HarsiratSinghJouhal/low_cost_analog_ecg_monitor/media/image01.jpg

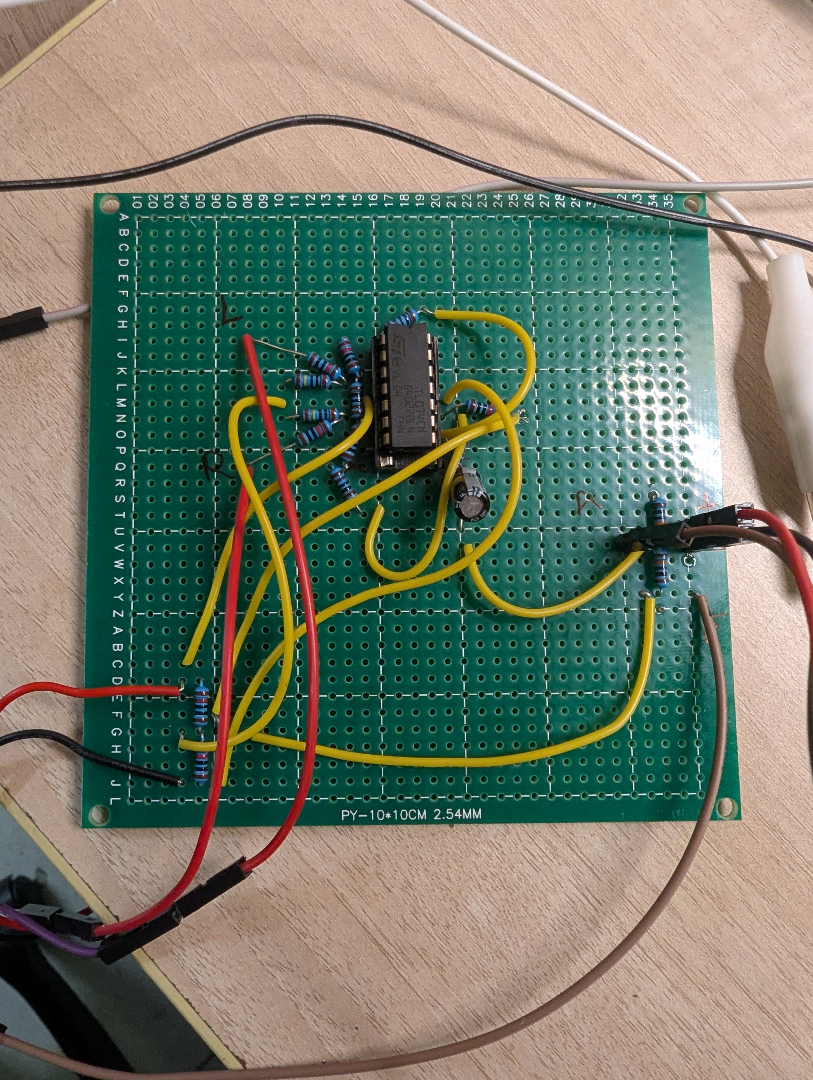
media/image01.jpg
