HarsiratSinghJouhal/low_cost_analog_ecg_monitor/media/image02.jpg

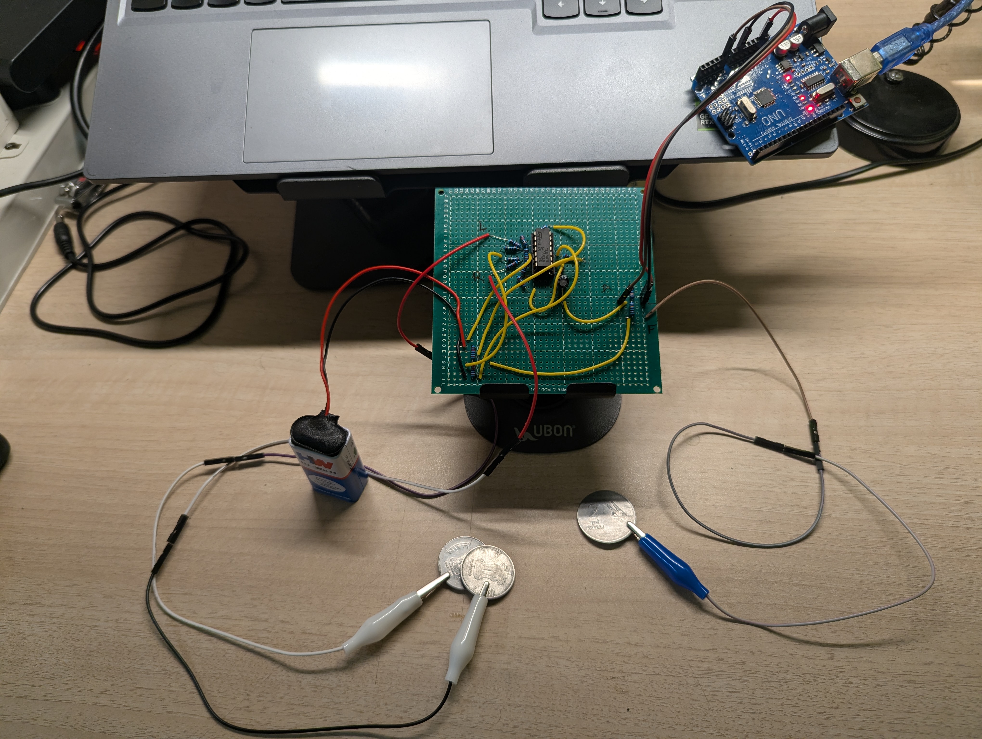
media/image02.jpg
