HarsiratSinghJouhal/low_cost_analog_ecg_monitor/media/image03.jpg

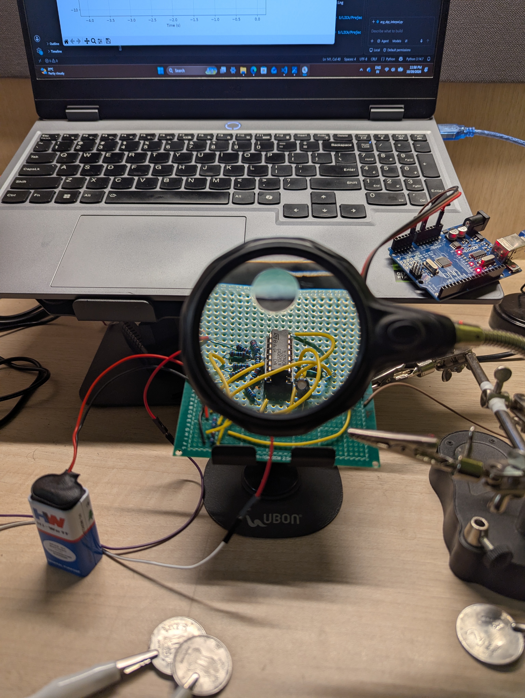
media/image03.jpg
