HarsiratSinghJouhal/low_cost_analog_ecg_monitor/media/image04.jpg

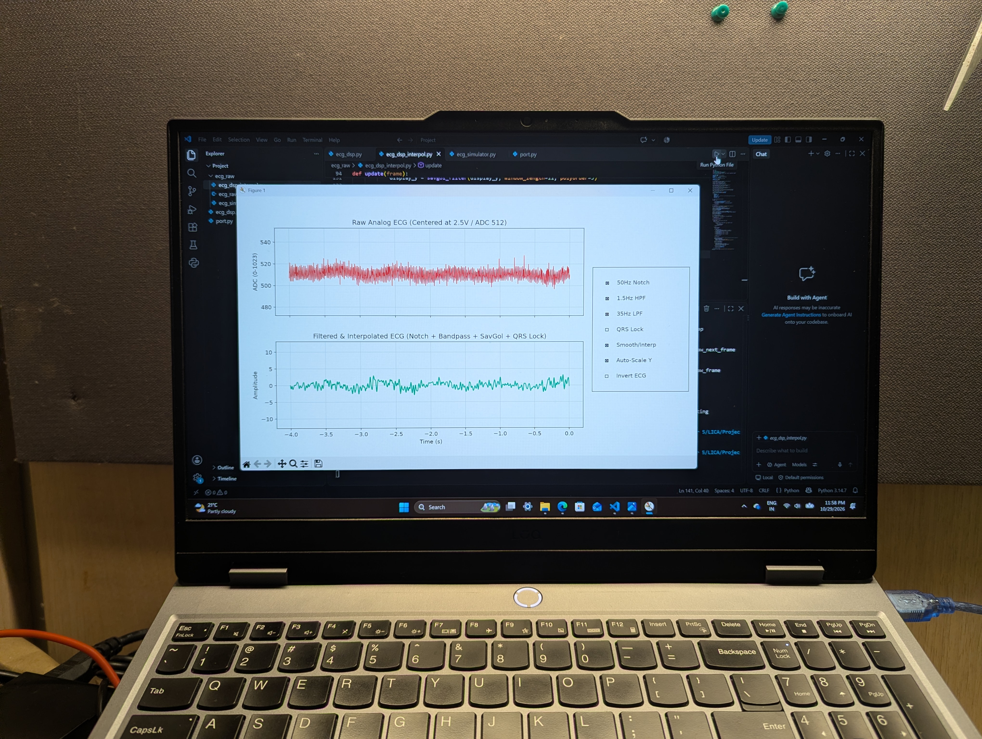
media/image04.jpg
