HarsiratSinghJouhal/low_cost_analog_ecg_monitor/media/image05.jpg

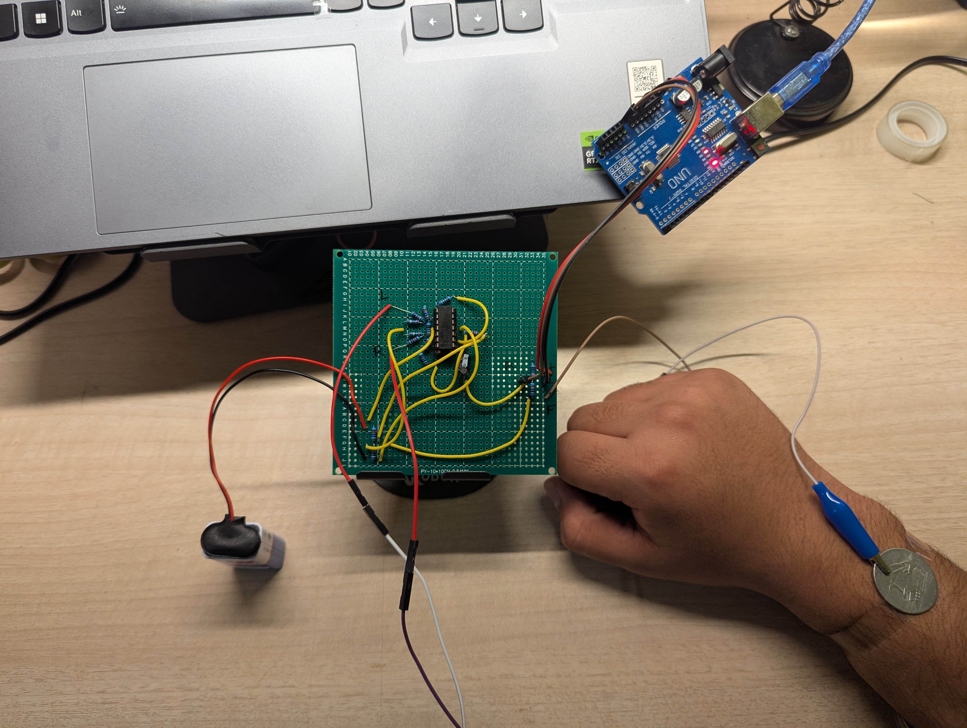
media/image05.jpg
