HarsiratSinghJouhal/low_cost_analog_ecg_monitor/media/image06.jpg

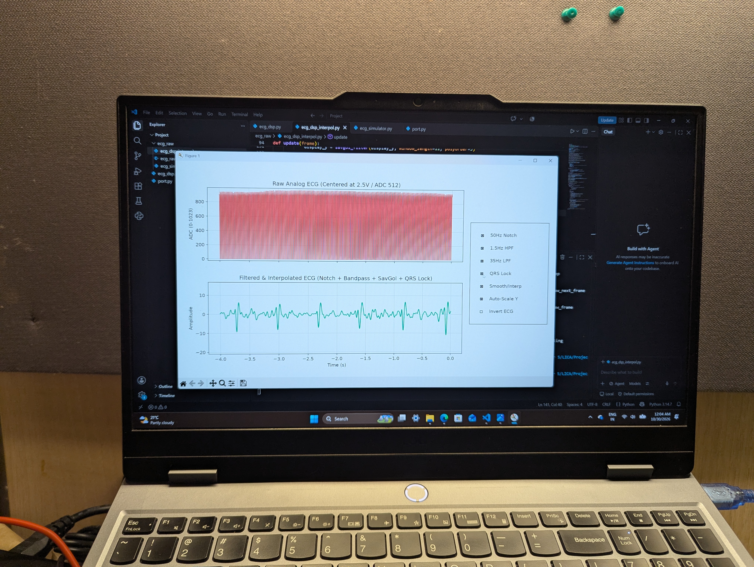
media/image06.jpg
