HarsiratSinghJouhal/low_cost_analog_ecg_monitor/media/image08.jpg

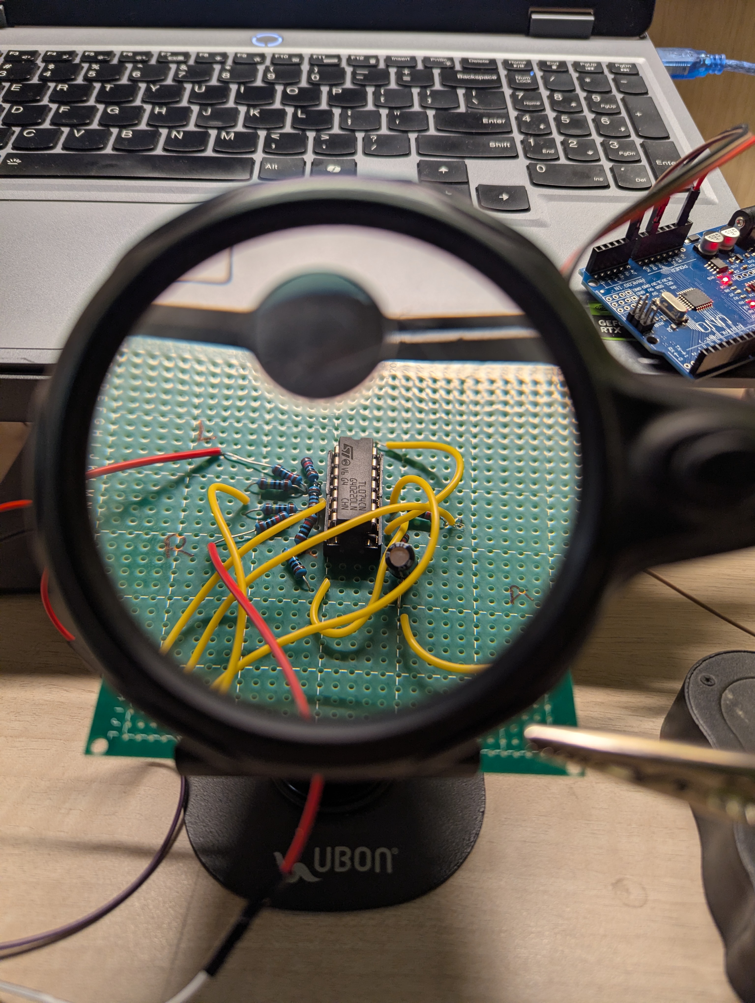
media/image08.jpg
