HarsiratSinghJouhal/low_cost_analog_ecg_monitor/media/waveform02.png

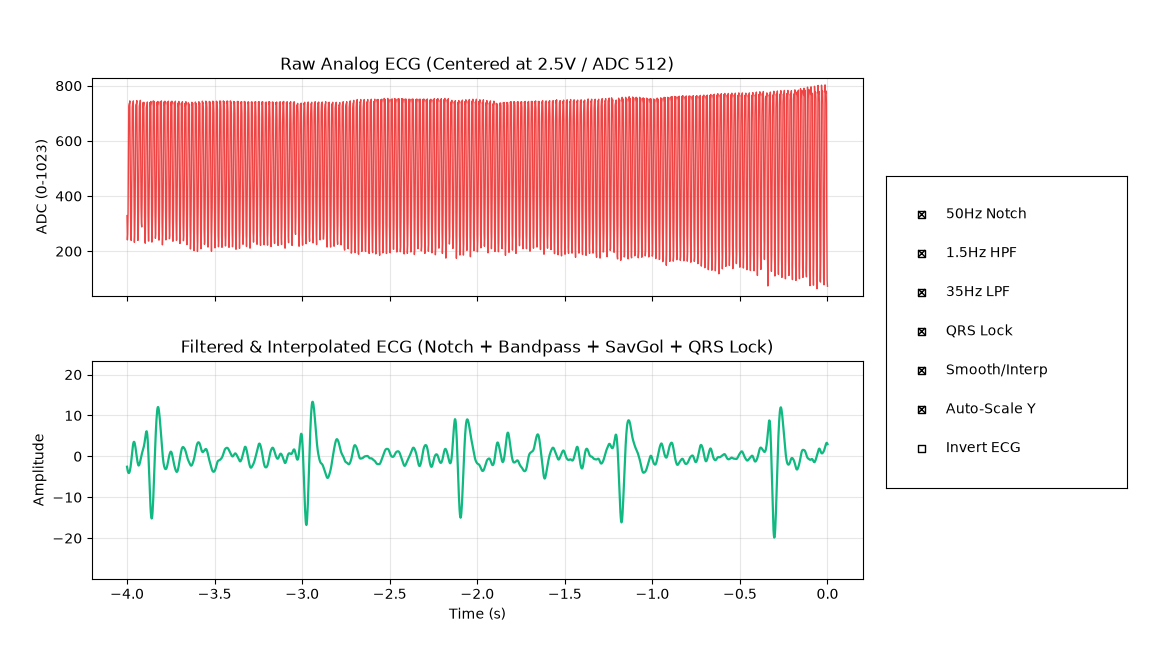
media/waveform02.png
