HarsiratSinghJouhal/low_cost_analog_ecg_monitor/media/waveform03.png

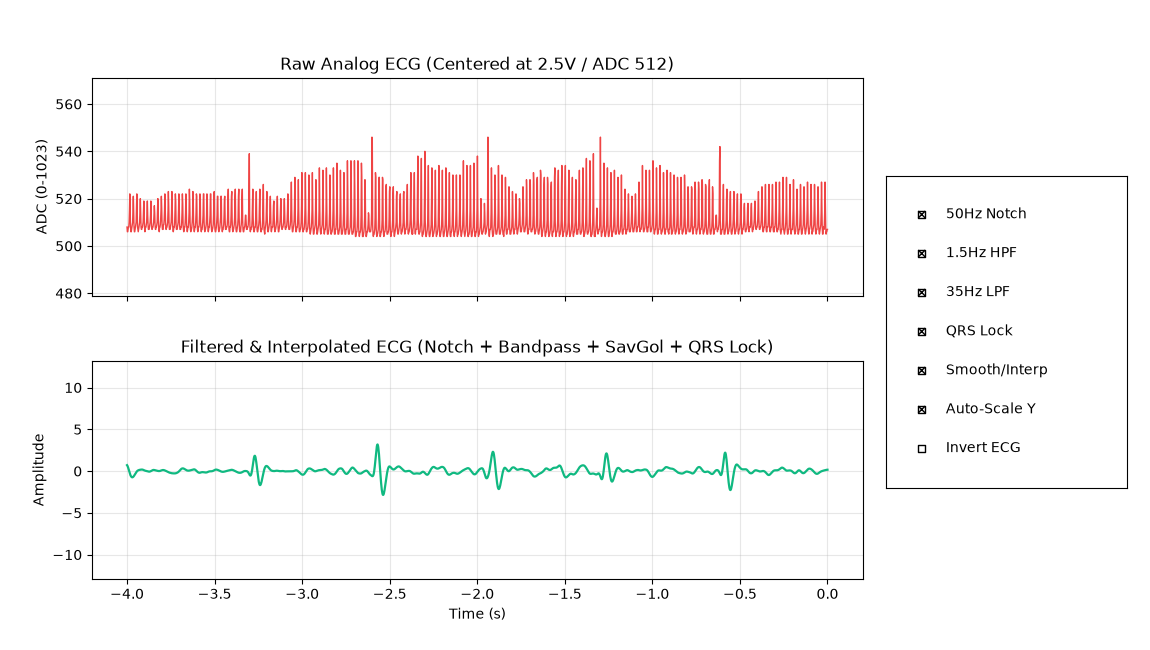
media/waveform03.png
