HarsiratSinghJouhal/low_cost_analog_ecg_monitor/hardware/schematic_ecg.pdf

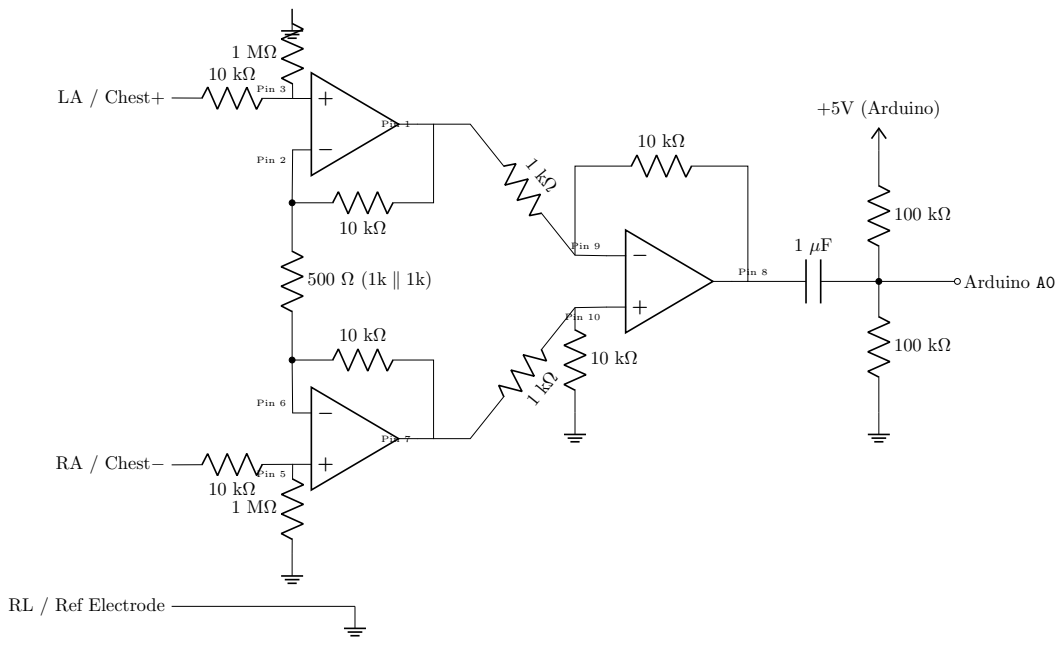
[picture p12: page 1]
Pin 1; Pin 3; Pin 2; Pin 7; Pin 5; Pin 6; LA / Chest+; RA / Chest−; Pin 9; Pin 10; Pin 8; +5V (Arduino); Arduino A0

RL / Ref Electrode
